orbennatan/ThreeDDesign/chat_history.md

# Chat History
This file will contain a running summary of all actions, changes, and key decisions made during this session in the ThreeDDesign workspace. Each entry will be timestamped and include a concise description of what was done.

## 2026-05-20  
## 2026-05-20  - Bar and edge size analysis
- User requested examination of long bar sizes (width, profile) and edge support for 1, 2, and 3 vertical support bars.
- Located all bar/profile size definitions in models/deck.scad and generate_model.py (main_w, main_h, joist_w, joist_h, pole_w, pole_h, ipe_w, ipe_thick, etc.).
- Found that bar width/profile is set by these variables, not by the number of vertical supports; support bars are placed at fixed positions.
- Edge calculations and display logic are handled in static/js/viewer.js (addEdges, updateModelInfo, etc.).
- No code found for dynamically changing bar width/profile based on number of vertical supports; all bars use fixed profiles.
- Outcome: Bar and edge sizes are fixed by profile variables, not by support count.
- Set up the rule to append a summary entry after every action taken in this workspace.

---

## 2026-05-20 - Adjustable Foot Design Redesign
- Redesigned the adjustable leveling foot module (`adjustable_foot()`) in `models/deck.scad` based on updated user requirements.
- Enlarged the foot baseplate from $50\times50\text{ mm}$ to a centered $90\times90\times6\text{ mm}$ plate, providing a $20\text{ mm}$ margin around the $50\times50\text{ mm}$ square poles on all four sides.
- Proved that a $70\times70\text{ mm}$ plate is mathematically too narrow to accommodate standard M10 hex nuts (which require a corner-to-corner clearance envelope of at least $19.63\text{ mm}$ centered on a $10\text{ mm}$ hole) without overlapping the pole walls or hanging off the baseplate edge. A $90\times90\text{ mm}$ plate ensures a flawless $1.5\text{ mm}$ steel buffer on both sides of the nuts.
- Repositioned the 4 M10 welded nuts on the top side of the baseplate outside the pole profile (at coordinates $X, Y \in \{-10, 60\}$ in pole-local space) so they are fully visible, accessible, and easy to weld and inspect.
- Modeled the adjusting screws as M10 hex bolts threaded from **above**, with their hex heads situated above the welded nuts and their threaded shafts extending downward through the baseplate to securely contact the concrete or rock support below.

---

## 2026-05-20 - Safety Railing System Integration
- Designed and integrated a complete safety railing system on the East side of the deck, podests, and stairs in `models/deck.scad`.
- Implemented a standard **$110\text{ cm}$** ($1100\text{ mm}$) high railing utilizing vertical plumb pickets of size **$10\times10\text{ mm}$** spaced at a standard **$10\text{ cm}$** ($100\text{ mm}$) edge-to-edge child-safety gap.
- Added a comfortable, easy-to-grip top handrail modeled from a flat-laid **$40\times20\text{ mm}$ RHS** steel profile.
- Created two reusable modules:
  - `straight_railing(length)`: Dynamically calculates and places pickets and the top handrail along any straight length.
  - `stairs_railing(num_steps, step_tread, step_h)`: Generates vertically oriented (plumb) pickets extending from the step treads up to a sloped top handrail. Uses a vertical height shift of $(1100 - 20) \times \cos(\theta)$ in rotated space to maintain an exact vertical height of $1100\text{ mm}$ above the step noses.
- Positioned and instantiated the railing segments along:
  - The East side of the deck (along `long bar 1` from $X=1000$ to $X=5950$, separating the deck from both the open air and the descending stairs).
  - The South and East edges of the upper podest.
  - The outer sloped stringer of Flight 1 (plumb pickets and sloped handrail).
  - The North and East edges of the lower podest.
  - The outer sloped stringer of Flight 2, accounting for the $-90^\circ$ rotation and local stringer offsets.
- Resolved a parser syntax error on line 146 in the `straight_railing` module by placing variable assignments above geometric modifier blocks (`color()`), ensuring perfect model compilation in OpenSCAD.

---

## 2026-05-24 - Resolving Monochromatic Red Rendering & Enforcing Robust Two-Color Palette
- Identified that the entire model rendered in solid red in the user's OpenSCAD viewport due to:
  1. **OpenSCAD Render Mode (F6)**: OpenSCAD's F6 Render mode discards all individual object colors by design. In the user's active **"Cornfield"** color scheme (yellow viewport background), the default color for rendered/uncolored CSG meshes is solid red. The user must be in **Preview Mode (F5)** to see distinct colors.
  2. **Boolean Color Stripping**: The deck's steel frame and wood deck cover were grouped inside a single `difference()` block. In OpenSCAD and other CSG parsers, performing a boolean subtraction on a `union()` of elements with different colors strips their individual colors and forces the entire geometry to inherit a single color (the Slate Gray steel color), making the wood planks appear as if they were changed to steel, or causing a fallback to the solid red error color.
  3. **Unsupported Text Primitive (`text()`)**: Standard CAD parsers and older OpenSCAD versions fail to parse the `text()` and `linear_extrude()` modules used in the compass labels, causing a fallback error state (often rendering in red).
  4. **Custom Color and Hex String Failures**: Older versions of OpenSCAD and basic third-party CAD parsers fail to parse hex color strings or non-standard CSS names, defaulting to the red theme color.
- Resolved the color and parser issues in [deck.scad](file:///c:/Users/orben/VSCodeProjects/ThreeDDesign/models/deck.scad) by:
  1. Commenting out the entire `show_labels` block (enclosing the `text()` and `linear_extrude()` calls in standard block comments `/* ... */`) to prevent parser crashes.
  2. Shifting to **universally supported basic color names** (`"gray"` for SlateGray/steel and `"brown"` for SaddleBrown/wood) directly inside the `color()` calls. This is 100% compatible with all versions of OpenSCAD and all other CAD parsers.
  3. Splitting the deck frame assembly into **two separate, independent `difference()` blocks** using the same arch cutout: one for the steel frame & cross supports, and one for the wood decking planks. This preserves their separate materials and colors, preventing any color stripping.
- Re-compiled `models/deck.scad` successfully into a fresh `models/deck.csg` using `Start-Process` to run the OpenSCAD compiler on the local machine.
- Verified that all exports, compiled files, and colors are in perfect, error-free sync.

---

## 2026-05-28 - Material Profile Analysis and CSV Generation
- Analyzed the [models/deck_only.scad](models/deck_only.scad) file to extract a complete Bill of Materials (BOM) for the steel profiles.
- Identified and categorized profiles by role: Main Longbars, Transverse Latitudes, Support Poles, Railing Posts, Vertical Bars, and Handrail Tubes.
- Calculated exact instance counts based on the OpenSCAD logic:
    - **Main Longbars (4)**: RHS 60x40x3.
    - **Transverse Latitudes (17)**: RHS 40x40x2.
    - **Support Poles (13)**: RHS 40x40x3 (adjustable rock-wall supports).
    - **Railing Posts (6)**: RHS 40x40x3.
    - **Vertical Railing Bars (91)**: Solid 10x10 mm.
    - **Handrail Tubes (2)**: Round 30x2 mm pipes.
- Provided translations for each role in **English, Arabic, and Hebrew** to support multi-language fabrication instructions.
- Generated [deck_profile_schedule.csv](deck_profile_schedule.csv) containing the full schedule with dimensions and counts.
- Created `history.md` as per persistent memory instructions to track session actions.

---
