orbennatan/ThreeDDesign/(list of files, cad)

Other CAD files:
models/deck_only.scad
models/stairs.scad
models/deck - Copy (2).scad
models/deck - Copy (3).scad
models/deck - Copy - Copy.scad
models/deck - Copy.scad
models/deck_4bars - Copy.scad
models/deck_only - Copy.scad
models/deck_only - Copy1.scad
