orbennatan/ThreeDDesign/(commit log)

2026-05-27 Refactor code structure for improved readability and maintainability
    [beam_support_poles.csv]
2026-05-27 Add deck-only model, isolated staircase, and truss staircase systems
    - Introduced a new model for a deck-only structure (deck_only.scad) featuring a 4-bar frame without stairs, including detailed assembly and railing specifications.
    - Created an isolated two-stage staircase system (stairs.scad) with structural modules for landings, stringers, and railings, designed to match original elevations.
    - Developed a truss-staircase system (truss_stairs.scad) with integrated truss profiles, optimized for structural integrity and aesthetic appeal, including detailed assembly and railing configurations.
    [deck - Copy (2).scad, deck - Copy (3).scad, deck - Copy - Copy.scad, deck - Copy.scad, deck_4bars - Copy.scad, deck_4bars.scad, deck_only.scad, stairs.scad]
2026-06-09 feat(deck): Introduce revised structural deck model with enhanced features
    - Added a new deck model with improved structural integrity, including larger primary beams, stronger transverse members, and reduced joist spacing.
    - Implemented diagonal bracing and railing gussets for added stability.
    - Updated dimensions and materials to align with Israeli residential engineering practices.
    - Introduced a new Python script for visualizing the path and structural elements of the deck.
    [deck_only - Copy.scad, deck_only - Copy1.scad, deck_only.scad, deck_profile_schedule.csv]
2026-06-09 feat(stairs): Add vertical balusters to staircase rail matching deck design
    [deck_only - Copy.scad]
2026-06-10 feat(stairs): Enhance stair geometry and rail structure for improved safety and compliance
    [deck_only - Copy.scad]
